houzheWang/InpedanceMeasurement/README.md

# InpedanceMeasurement

Task：Design a impedance measurement instumentation

Requirements：which can measure the resistance, inductance and capacitance or some more complex LCR circuits. 

PCB design, schematic diagrams, the report etc. are included.
